GonzagaEagles16/Boston/BostonV0.3 - older two PCB design/KiCAD files - controller - STM32/Boston-controller-STM32.kicad_pcb

## KiCad design BostonV0.3 - older two PCB design/KiCAD files - controller - STM32/Boston-controller-STM32.kicad_pcb (2020-08-08, an earlier design)

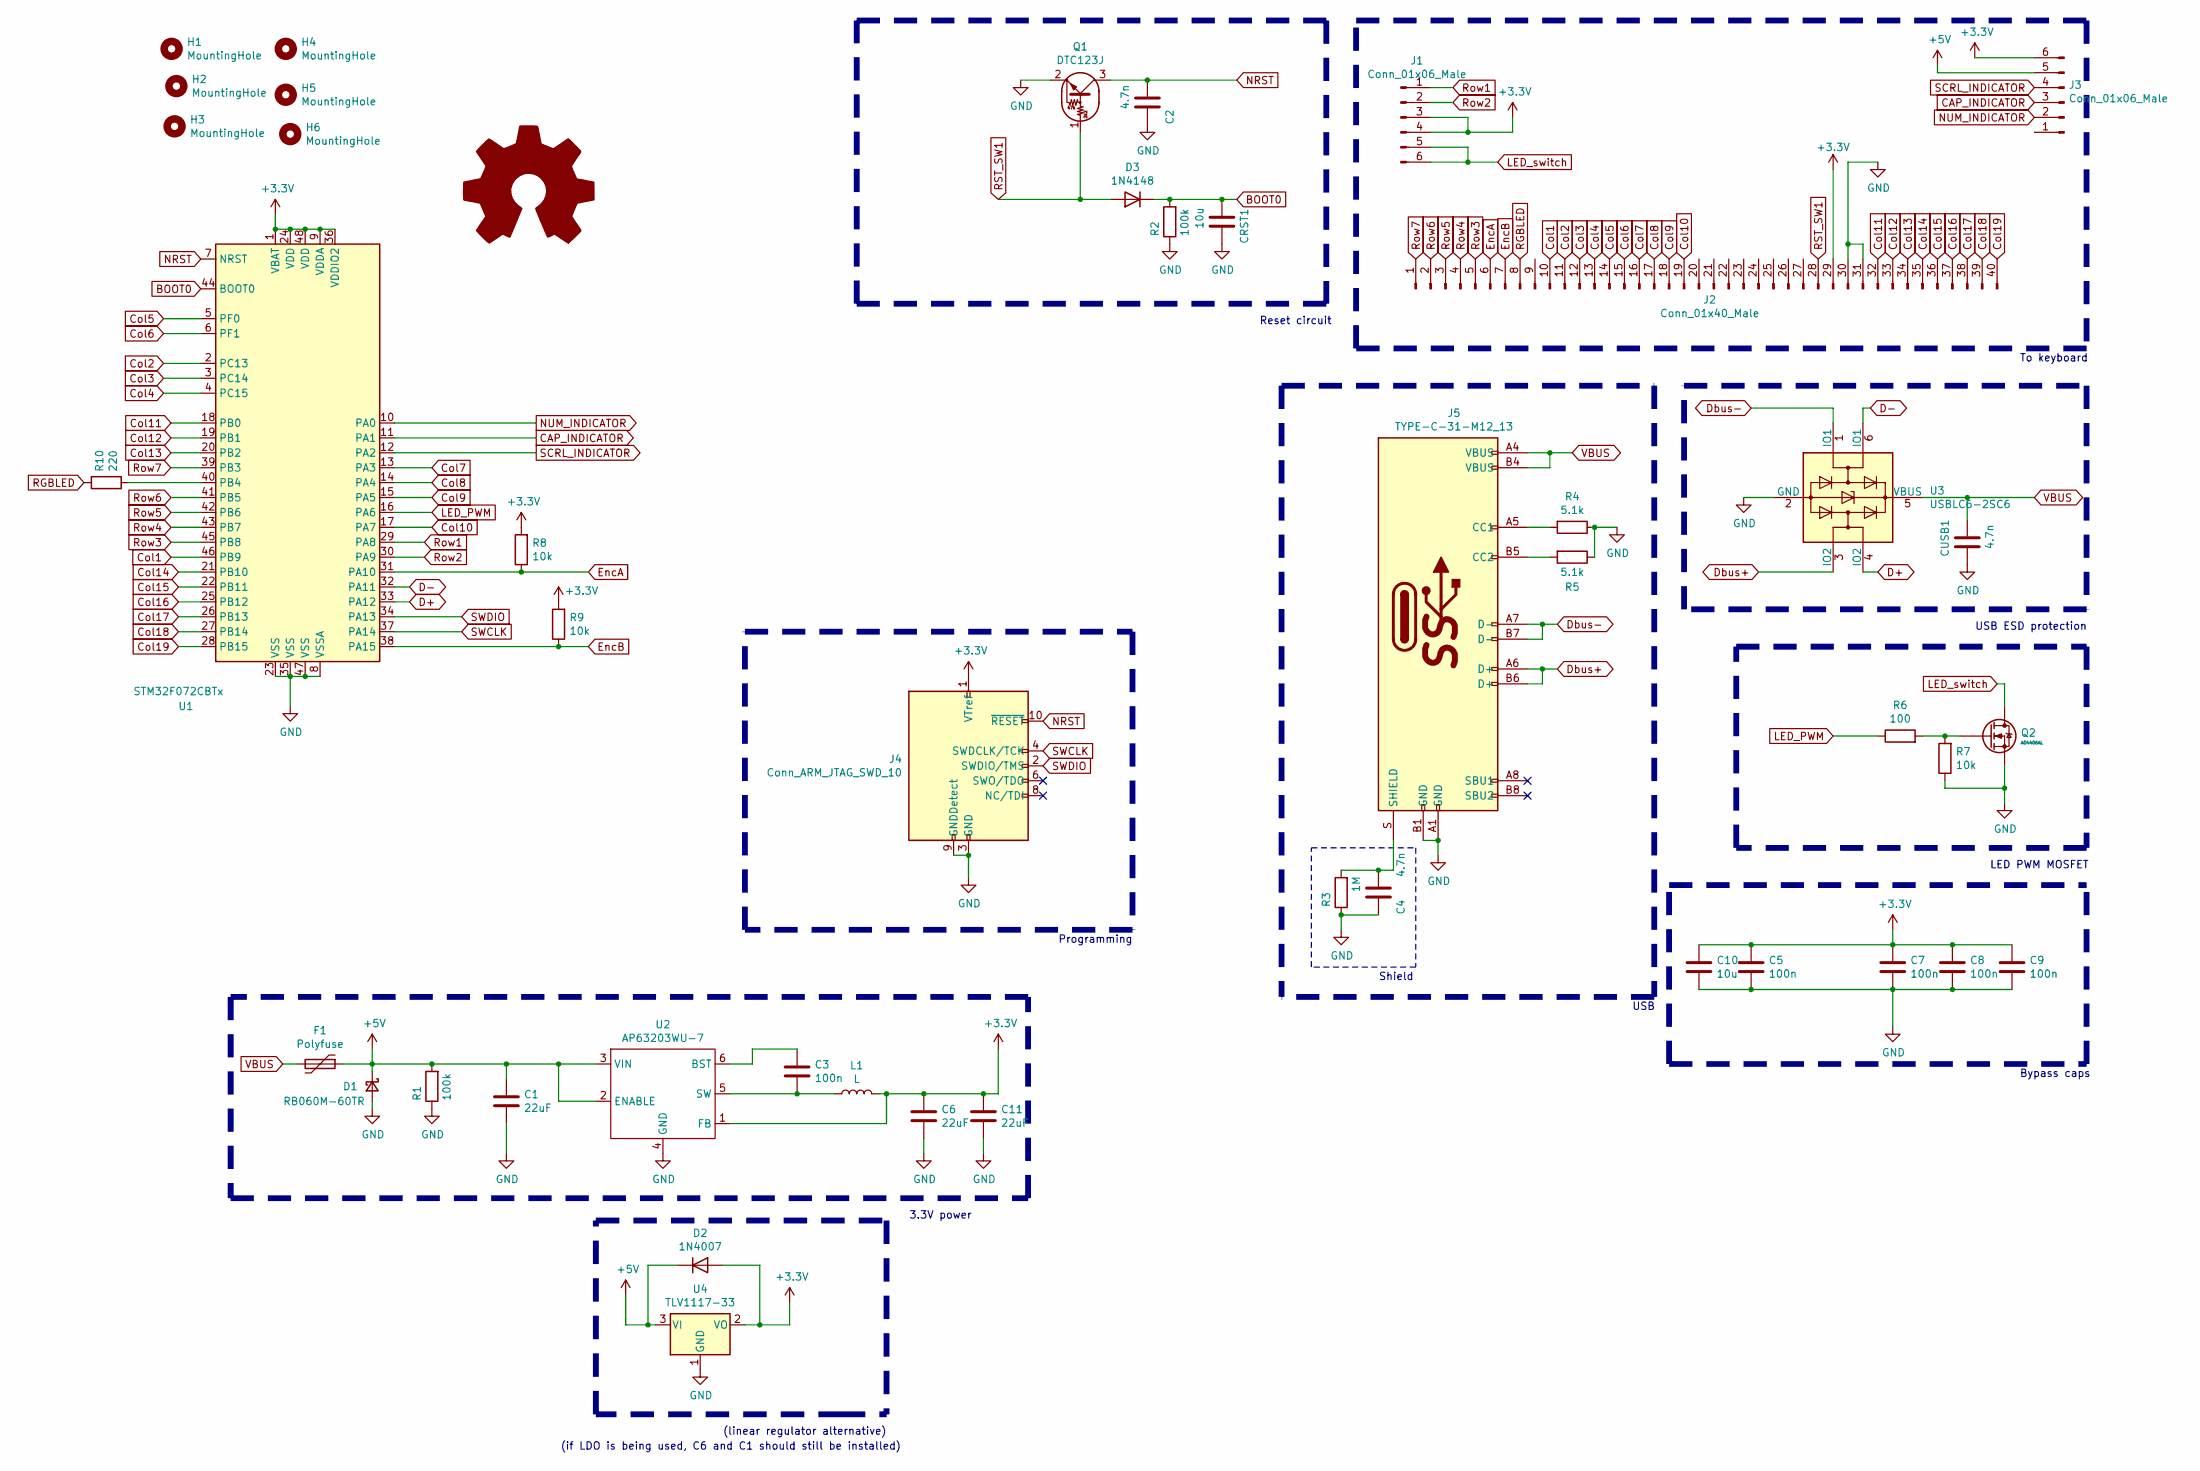
[picture p1: schematic Boston-controller-STM32.kicad_sch]

Parts:
C1, C6, C11: 22uF; C_1210_3225Metric_Pad1.42x2.65mm_HandSolder
C2, C4: 4.7n; C_0805_2012Metric_Pad1.15x1.40mm_HandSolder
C3, C5, C7, C8, C9: 100n; C_0805_2012Metric_Pad1.15x1.40mm_HandSolder
C10: 10u; C_1206_3216Metric_Pad1.42x1.75mm_HandSolder
CRST1: 10u; C_1206_3216Metric
CUSB1: 4.7n; C_0805_2012Metric_Pad1.15x1.40mm_HandSolder
D1: RB060M-60TR; D_SOD-123
D2: 1N4007; D_DO-41_SOD81_P10.16mm_Horizontal
D3: 1N4148; D_DO-35_SOD27_P7.62mm_Horizontal
F1: Polyfuse; Fuse_1812_4532Metric_Pad1.30x3.40mm_HandSolder
H1, H2: MountingHole; MountingHole_3.2mm_M3_ISO7380
H3, H4, H5, H6: MountingHole
J1, J3: Conn_01x06_Male; PinHeader_1x06_P2.00mm_Vertical
J2: Conn_01x40_Male; PinHeader_1x40_P2.00mm_Vertical
J4: Conn_ARM_JTAG_SWD_10; PinHeader_2x05_P2.54mm_Vertical
J5: TYPE-C-31-M12_13; TYPE-C-31-M-12
L1: L; L_Taiyo-Yuden_NR-50xx_HandSoldering
LOGO1: Logo_Open_Hardware_Large; OSHW-Logo2_9.8x8mm_SilkScreen
Q1: DTC123J; SOT-23
Q2: AO4406AL; SOIC-8
R1, R2: 100k; R_0805_2012Metric_Pad1.15x1.40mm_HandSolder
R3: 1M; R_0805_2012Metric_Pad1.15x1.40mm_HandSolder
R4, R5: 5.1k; R_0805_2012Metric_Pad1.15x1.40mm_HandSolder
R6: 100; R_0805_2012Metric_Pad1.15x1.40mm_HandSolder
R7, R8, R9: 10k; R_0805_2012Metric_Pad1.15x1.40mm_HandSolder
R10: 220; R_0805_2012Metric_Pad1.15x1.40mm_HandSolder
U1: STM32F072CBTx; LQFP-48_7x7mm_P0.5mm
U2: AP63203WU-7; TSOT-23-6_HandSoldering
U3: USBLC6-2SC6; SOT-23-6
U4: TLV1117-33; SOT-223-3_TabPin2

Connections:
+3V3: C5.1, C6.1, C7.1, C8.1, C9.1, C10.1, C11.1, D2.2 (A), J1.3, J1.4, J2.29, J3.6, J4.1 (VTref), L1.2, R8.2, R9.2, U1.1 (VBAT), U1.9 (VDDA), U1.24 (VDD), U1.36 (VDDIO2), U1.48 (VDD), U2.1 (FB), U4.2 (VO)
+5V: C1.1, D1.1 (K), D2.1 (K), F1.1, J3.5, R1.2, U2.2 (ENABLE), U2.3 (VIN), U4.3 (VI)
BOOT0: CRST1.1, D3.1 (K), R2.2, U1.44 (BOOT0)
CAP_INDICATOR: J3.3, U1.11 (PA1)
Col1: J2.10, U1.46 (PB9)
Col2: J2.11, U1.2 (PC13)
Col3: J2.12, U1.3 (PC14)
Col4: J2.13, U1.4 (PC15)
Col5: J2.14, U1.5 (PF0)
Col6: J2.15, U1.6 (PF1)
Col7: J2.16, U1.13 (PA3)
Col8: J2.17, U1.14 (PA4)
Col9: J2.18, U1.15 (PA5)
Col10: J2.19, U1.17 (PA7)
Col11: J2.32, U1.18 (PB0)
Col12: J2.33, U1.19 (PB1)
Col13: J2.34, U1.20 (PB2)
Col14: J2.35, U1.21 (PB10)
Col15: J2.36, U1.22 (PB11)
Col16: J2.37, U1.25 (PB12)
Col17: J2.38, U1.26 (PB13)
Col18: J2.39, U1.27 (PB14)
Col19: J2.40, U1.28 (PB15)
D+: U1.33 (PA12), U3.4 (IO2)
D-: U1.32 (PA11), U3.6 (IO1)
Dbus+: J5.A6 (D+), J5.B6 (D+), U3.3 (IO2)
Dbus-: J5.A7 (D-), J5.B7 (D-), U3.1 (IO1)
EncA: J2.6, R8.1, U1.31 (PA10)
EncB: J2.7, R9.1, U1.38 (PA15)
GND: C1.2, C2.2, C4.2, C5.2, C6.2, C7.2, C8.2, C9.2, C10.2, C11.2, CRST1.2, CUSB1.2, D1.2 (A), J2.30, J2.31, J4.3 (GND), J4.5 (GND), J4.9 (GNDDetect), J5.A1 (GND), J5.B1 (GND), Q1.2 (E), Q2.1, Q2.2, Q2.3, R1.1, R2.1, R3.1, R4.1, R5.1, R7.1, U1.8 (VSSA), U1.23 (VSS), U1.35 (VSS), U1.47 (VSS), U2.4 (GND), U3.2 (GND), U4.1 (GND)
LED_PWM: R6.1, U1.16 (PA6)
LED_switch: J1.5, J1.6, Q2.5 (D), Q2.6, Q2.7, Q2.8
NRST: C2.1, J4.10 (~RESET~), Q1.3 (C), U1.7 (NRST)
NUM_INDICATOR: J3.2, U1.10 (PA0)
unnamed: C3.1, U2.6 (BST)
unnamed: C3.2, L1.1, U2.5 (SW)
unnamed: C4.1, J5.S (SHIELD), R3.2
unnamed: J5.A5 (CC1), R4.2
unnamed: J5.B5 (CC2), R5.2
unnamed: Q2.4 (G), R6.2, R7.2
unnamed: R10.1, U1.40 (PB4)
RGBLED: J2.8, R10.2
RST_SW1: D3.2 (A), J2.28, Q1.1 (B)
Row1: J1.1, U1.29 (PA8)
Row2: J1.2, U1.30 (PA9)
Row3: J2.5, U1.45 (PB8)
Row4: J2.4, U1.43 (PB7)
Row5: J2.3, U1.42 (PB6)
Row6: J2.2, U1.41 (PB5)
Row7: J2.1, U1.39 (PB3)
SCRL_INDICATOR: J3.4, U1.12 (PA2)
SWCLK: J4.4 (SWDCLK/TCK), U1.37 (PA14)
SWDIO: J4.2 (SWDIO/TMS), U1.34 (PA13)
VBUS: CUSB1.1, F1.2, J5.A4 (VBUS), J5.B4 (VBUS), U3.5 (VBUS)

Notes on the sheet:
(linear regulator alternative)
(if LDO is being used, C6 and C1 should still be installed)
3.3V power
Programming
Reset circuit
Shield
USB
USB ESD protection
LED PWM MOSFET
To keyboard
Bypass caps

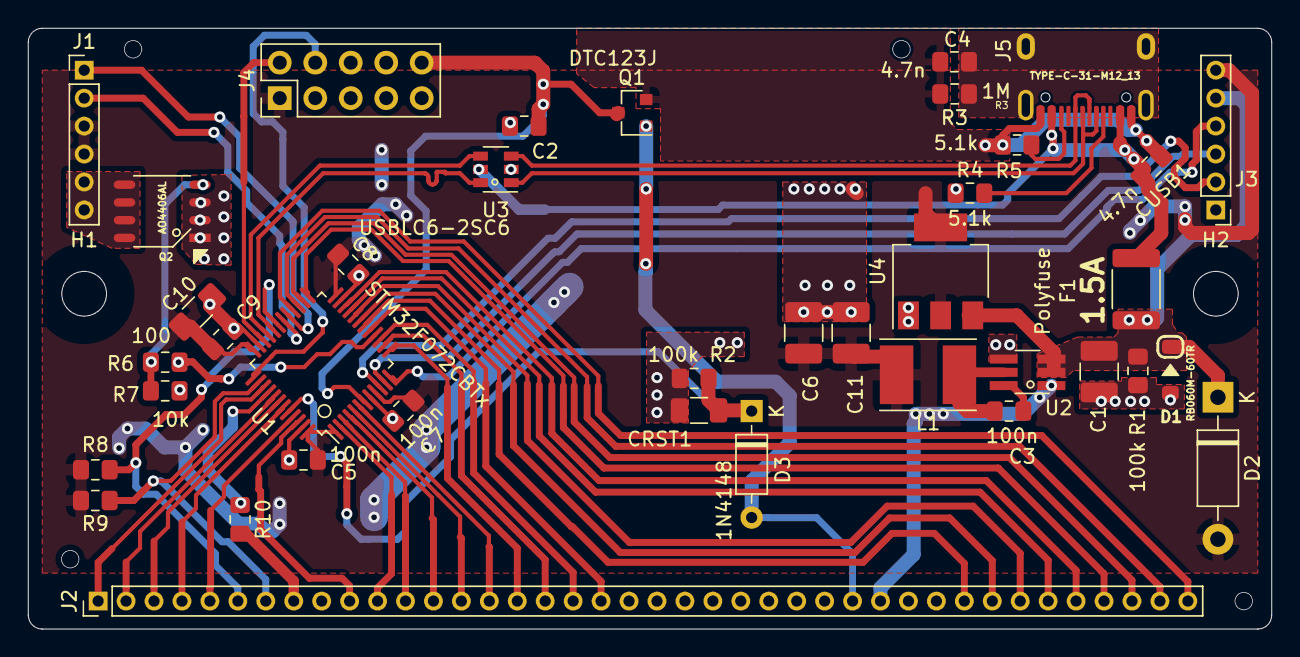
[picture p2: board Boston-controller-STM32.kicad_pcb from above]

Board: 2 copper layers, 89.0 x 43.0 mm, 42 parts (1 on the bottom side), 54 nets.
