GonzagaEagles16/Boston/Boston - Current design/3D printed version/Bottom/KiCAD files/bottom.kicad_sch

## KiCad design Boston - Current design/3D printed version/Bottom/KiCAD files/bottom.kicad_sch (2020-09-17)

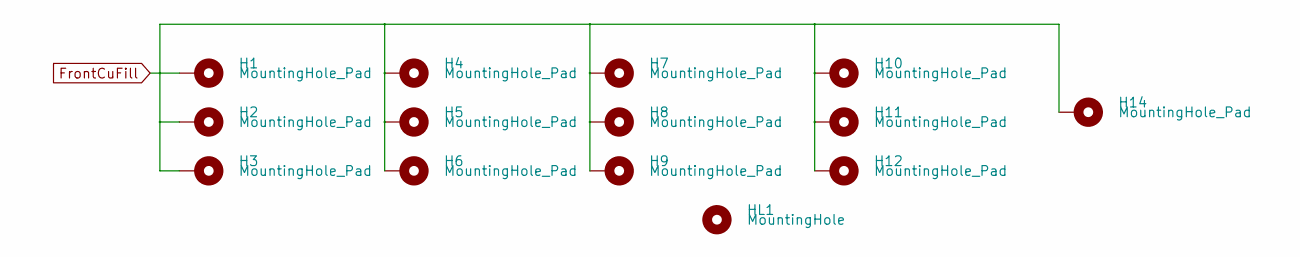
[picture p7: schematic bottom.kicad_sch]

Parts:
H1, H2, H3, H4, H5, H6, H7, H8, H9, H10, H11, H12: MountingHole_Pad; MountingHole_3.2mm_M3_ISO7380_Pad
H14: MountingHole_Pad; MountingHole_2.5mm_Pad
HL1: MountingHole; boston-streets-thinner-5

Connections:
FrontCuFill: H1.1, H2.1, H3.1, H4.1, H5.1, H6.1, H7.1, H8.1, H9.1, H10.1, H11.1, H12.1, H14.1
